jabgrall/Angel_Night-light/CAO/FreeCAD/Capot Batterie.FCStd

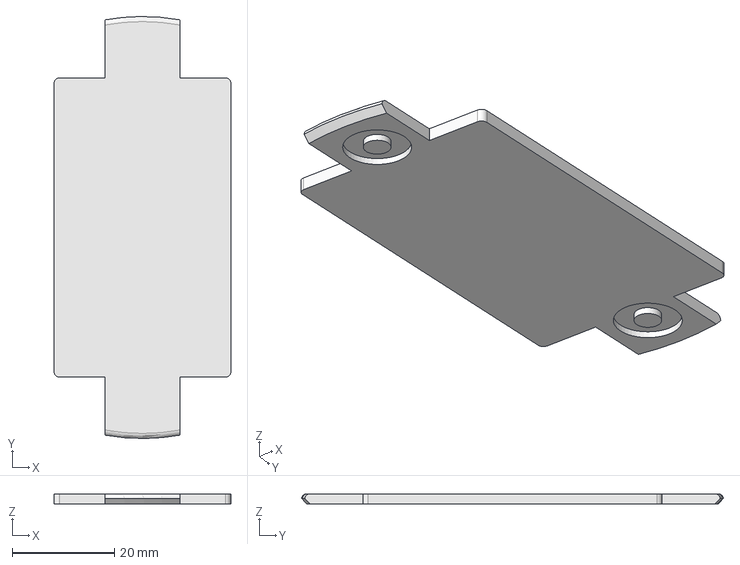
[picture p1: CAD file, 2022-08-26]
CAO/FreeCAD/Capot Batterie.FCStd
34.6 x 82.7 x 2.00 mm
