jabgrall/Angel_Night-light/CAO/FreeCAD/STL/V2_ElecTop-Fusion.stl

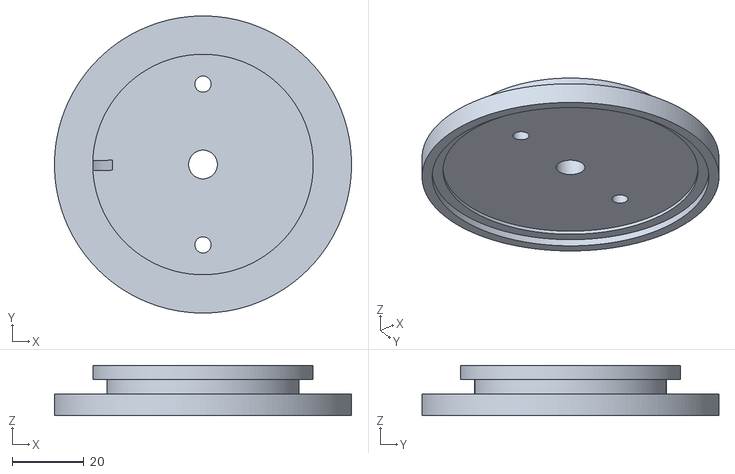
[picture p2: CAD file, 2022-08-25]
CAO/FreeCAD/STL/V2_ElecTop-Fusion.stl
82.7 x 82.6 x 14.0
