jabgrall/Angel_Night-light/CAO/FreeCAD/V2a_ElecBottom.FCStd

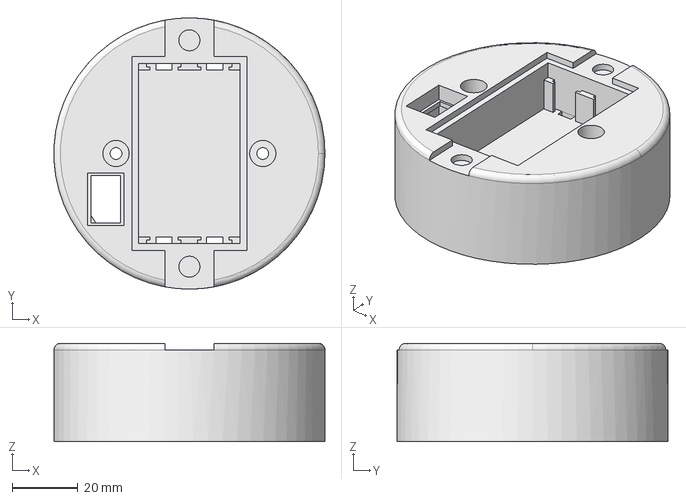
[picture p3: CAD file, 2022-08-25]
CAO/FreeCAD/V2a_ElecBottom.FCStd
82.6 x 82.7 x 30.0 mm
