jabgrall/Angel_Night-light/CAO/FreeCAD/Boitier Elec.FCStd

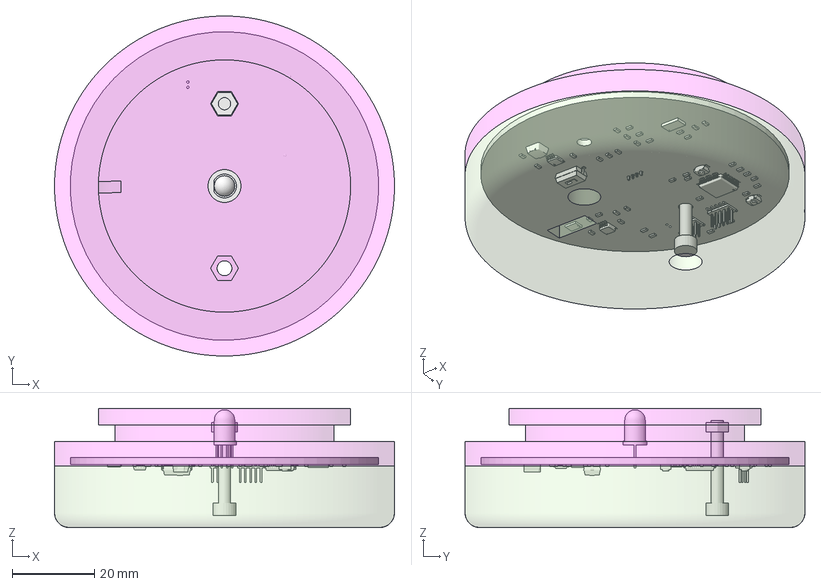
[picture p4: CAD file, 2022-03-18]
CAO/FreeCAD/Boitier Elec.FCStd
82.7 x 82.6 x 29.0 mm
PCB
Vis CHC M3x20
Ecrou M3
Ange-ElecTop
Ange-ElecBottom
