jabgrall/Angel_Night-light/CAO/FreeCAD/Ange_base.FCStd

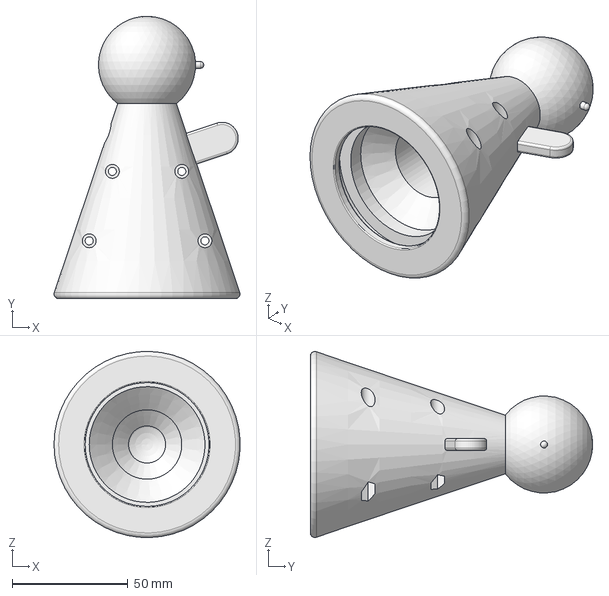
[picture p5: CAD file, 2022-03-18]
CAO/FreeCAD/Ange_base.FCStd
80.4 x 122.0 x 80.4 mm
