jabgrall/Angel_Night-light/CAO/FreeCAD/STL/PCB.stl

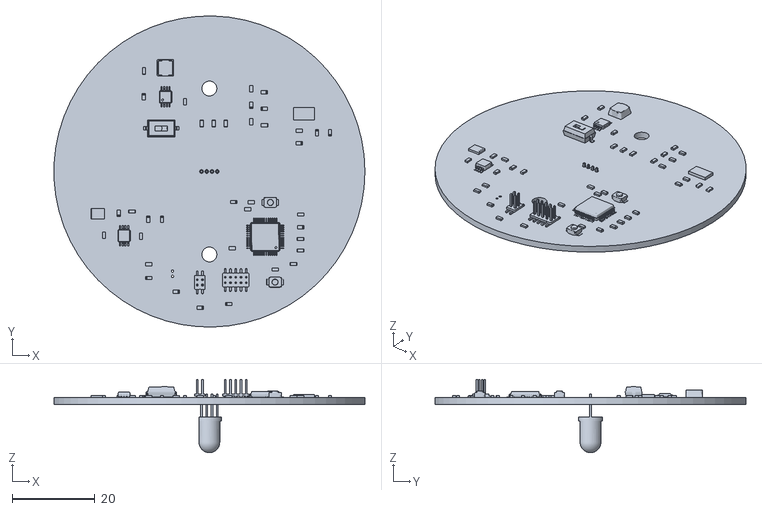
[picture p6: CAD file, 2021-09-29]
CAO/FreeCAD/STL/PCB.stl
75.0 x 75.0 x 17.7
