jabgrall/Angel_Night-light/CAO/FreeCAD/Ange_droite.FCStd

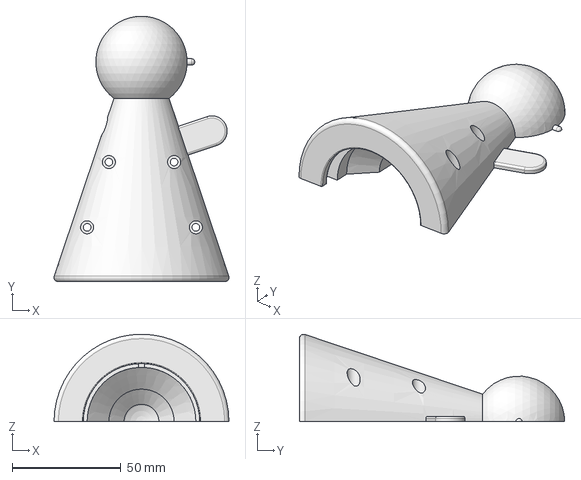
[picture p7: CAD file, 2021-09-29]
CAO/FreeCAD/Ange_droite.FCStd
80.4 x 122.0 x 40.2 mm
