jabgrall/Angel_Night-light/CAO/FreeCAD/Ange_aile.FCStd

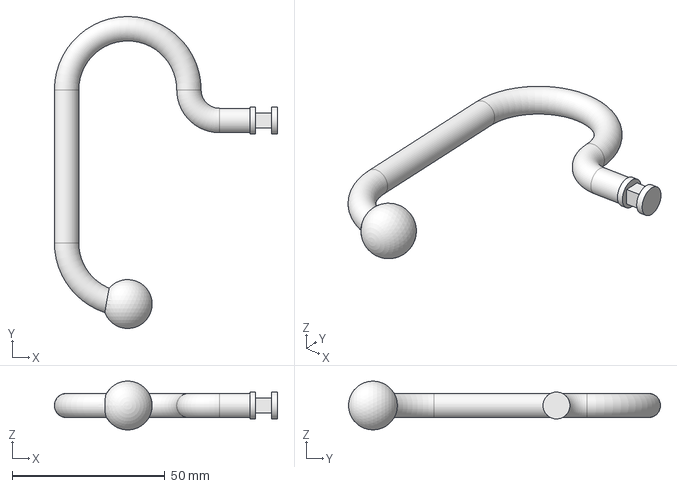
[picture p8: CAD file, 2021-09-29]
CAO/FreeCAD/Ange_aile.FCStd
73.0 x 102.0 x 15.9 mm
