jabgrall/Angel_Night-light/CAO/FreeCAD/Vis CHC M3x20.FCStd

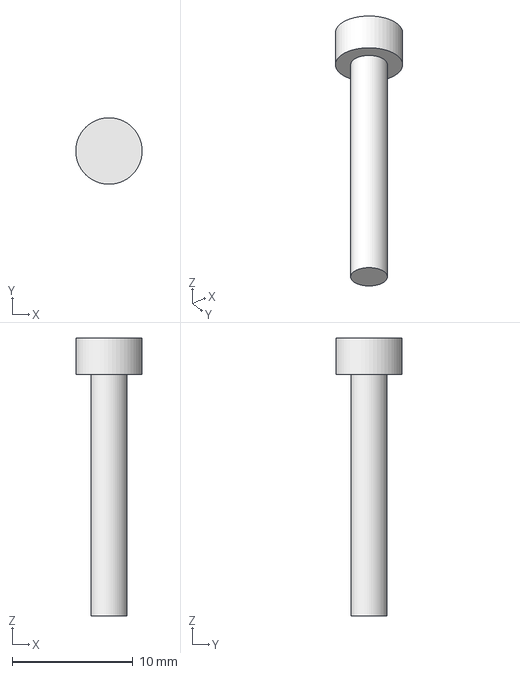
[picture p9: CAD file, 2021-09-29]
CAO/FreeCAD/Vis CHC M3x20.FCStd
5.49 x 5.50 x 23.0 mm
