jabgrall/Angel_Night-light/CAO/FreeCAD/Ecrou M3.FCStd

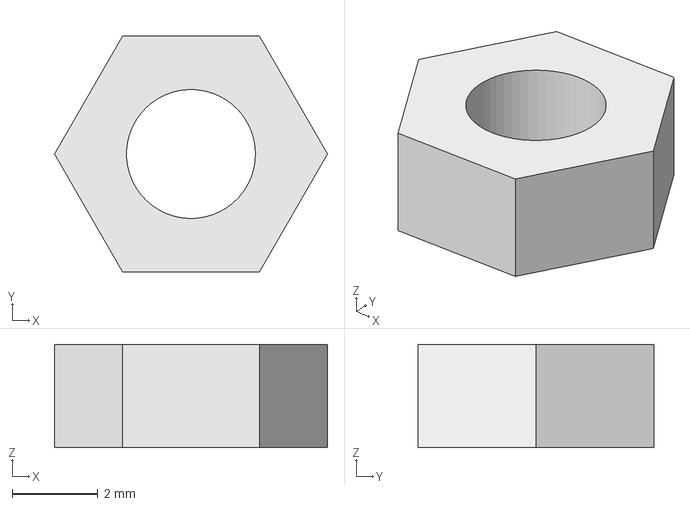
[picture p10: CAD file, 2021-09-29]
CAO/FreeCAD/Ecrou M3.FCStd
6.35 x 5.50 x 2.40 mm
