jabgrall/Angel_Night-light/CAO/FreeCAD/Ange_gauche.FCStd

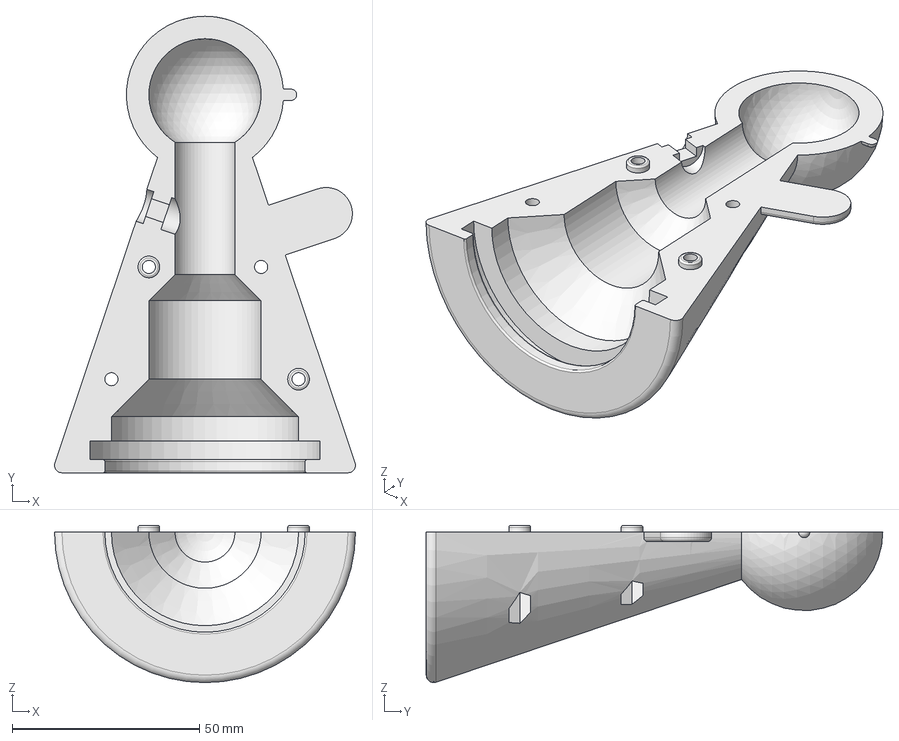
[picture p11: CAD file, 2021-09-29]
CAO/FreeCAD/Ange_gauche.FCStd
80.4 x 122.0 x 42.0 mm
