jabgrall/Angel_Night-light/(list of files, cad)

Other CAD files:
CAO/FreeCAD/STL/Capot Batterie-BodyPocket.stl
CAO/FreeCAD/STL/V2a_ElecBottom-BodyFillet.stl
CAO/FreeCAD/V2_ElecTop.FCStd
CAO/FreeCAD/STL/V2a_ElecTop-Fusion.stl
CAO/FreeCAD/STL/Ange_aile.stl
CAO/FreeCAD/STL/Ange_droite.stl
CAO/FreeCAD/STL/Ange_gauche.stl
CAO/FreeCAD/STL/Ecrou M3.stl
CAO/FreeCAD/STL/Vis CHC M3x20.stl
