jabgrall/Angel_Night-light/PCB/PCB-Ange.pdf

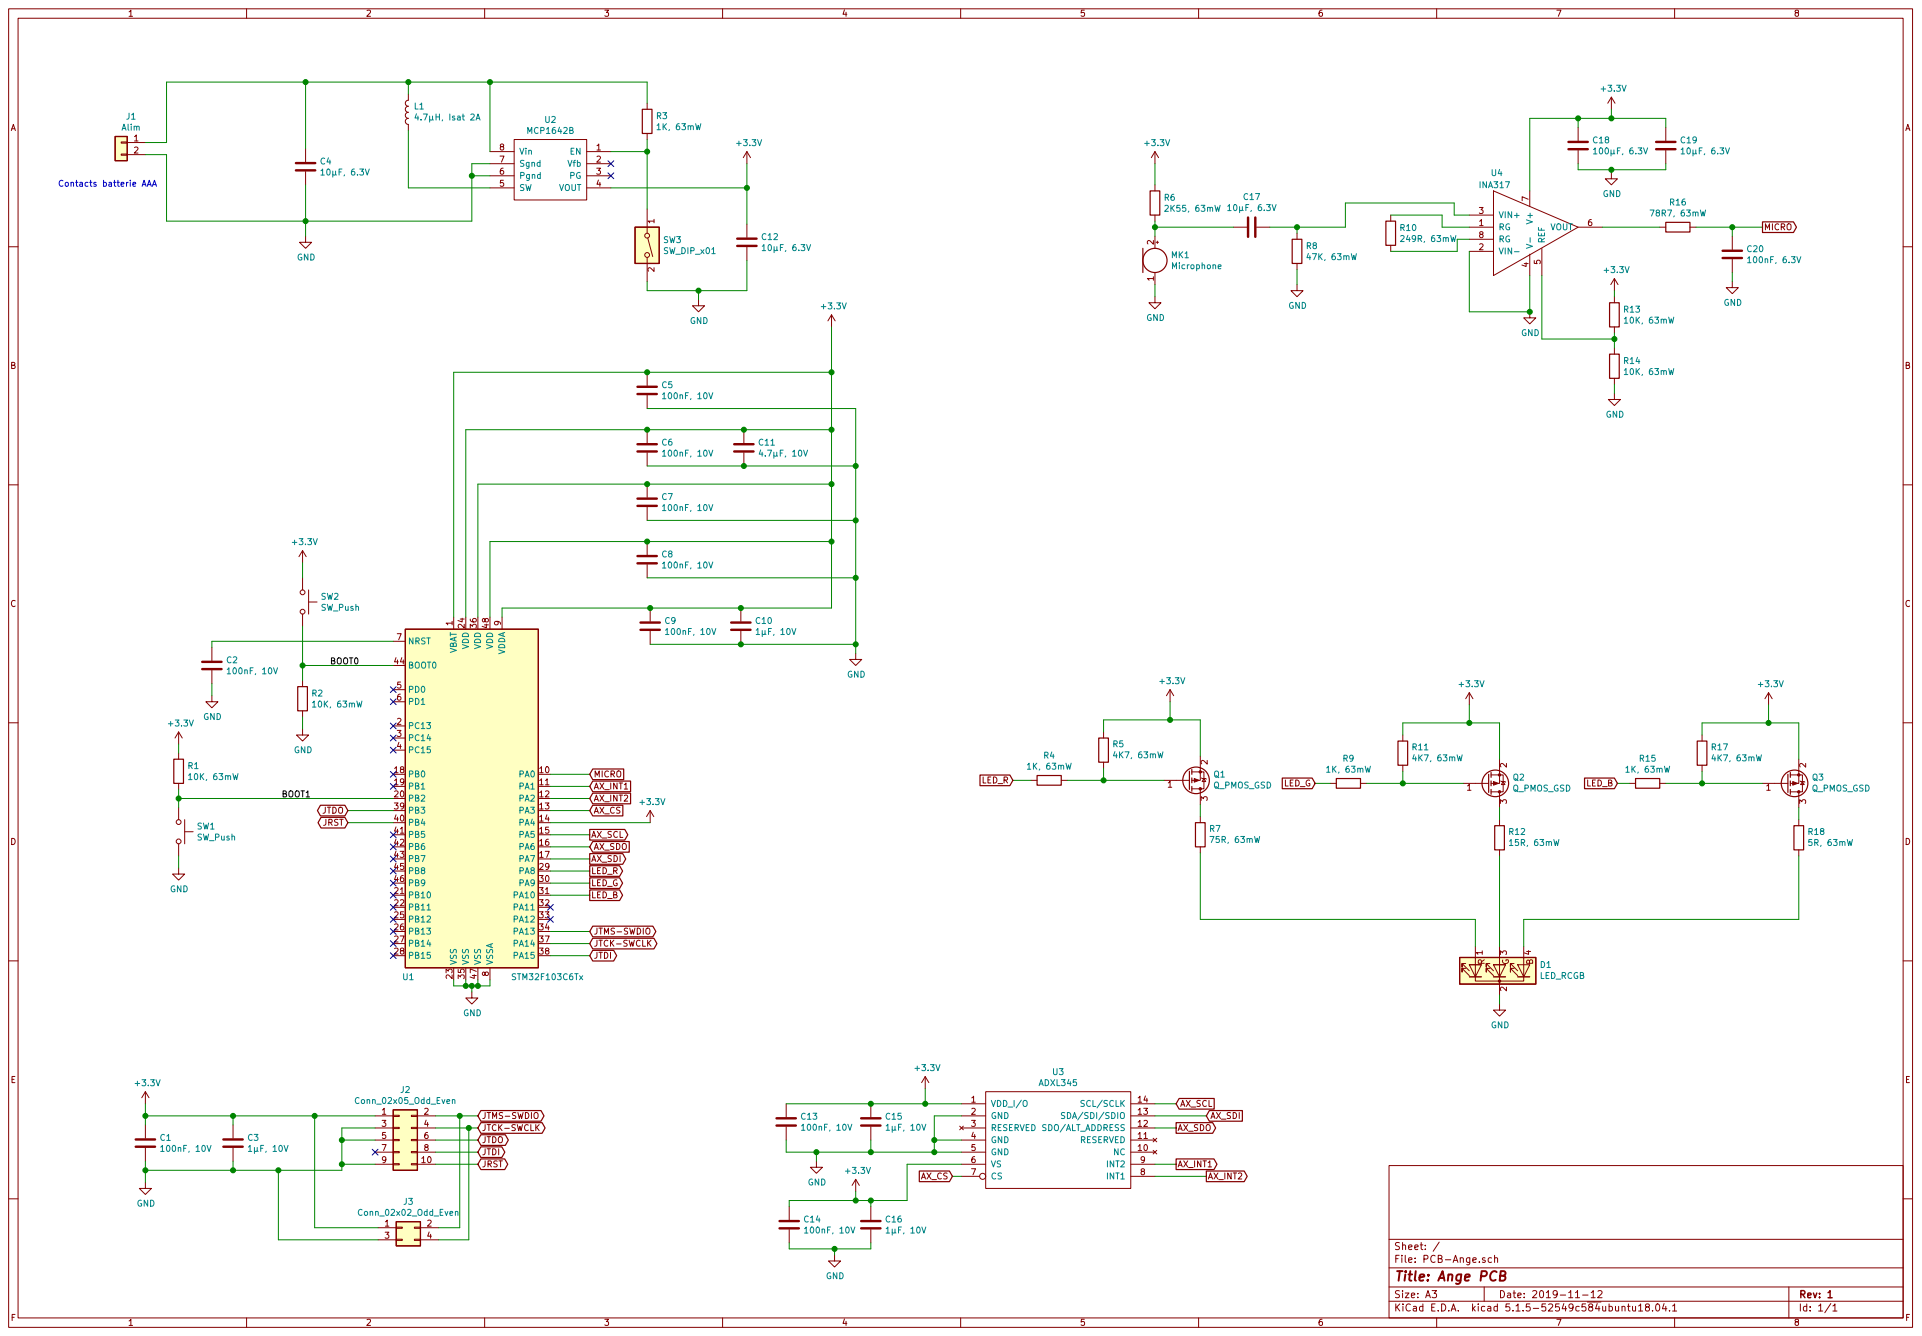
[picture p12: page 1]

1 2 MK1 Microphone RG 1 VIN- 2 VIN+ 3 V- 4 REF

1 VDD 24 VDD 36 VDD 48 VDDA

9 VSS 23 VSS 35 VSS 47 VSSA

7 9 | 8

File: PCB-Ange.sch Sheet: /
Id: 1/1 Title: Ange PCB
