jabgrall/Angel_Night-light/PCB/PCB-Ange.kicad_pcb

## KiCad design PCB/PCB-Ange.kicad_pcb (2022-08-25)

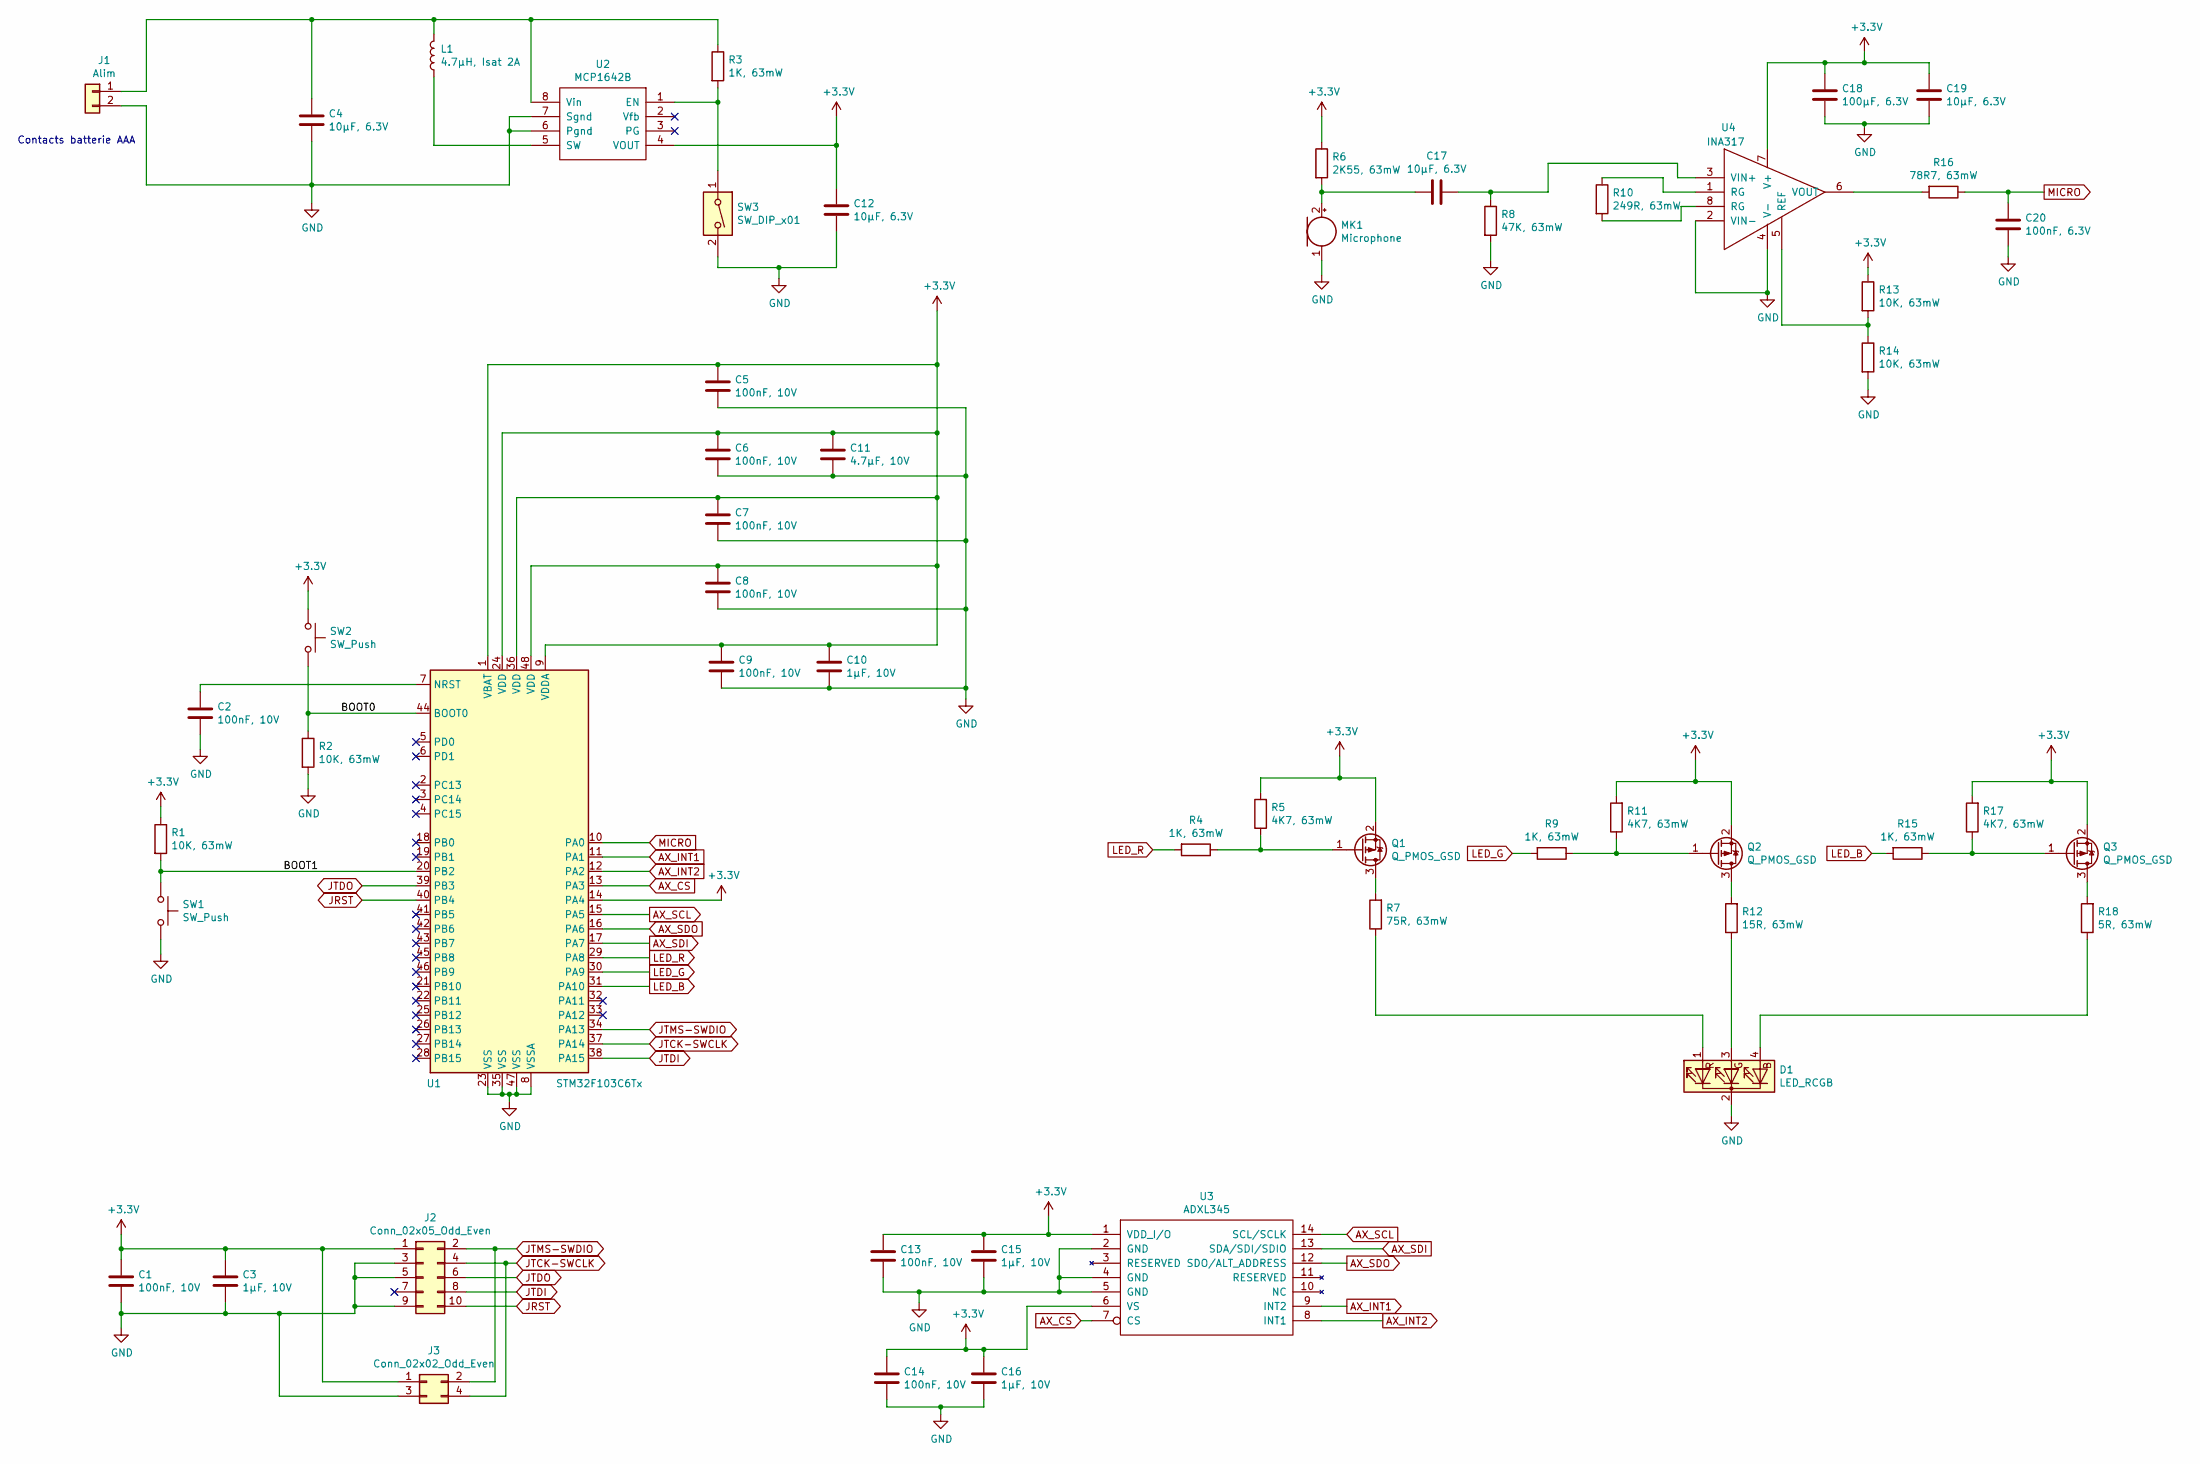
[picture p13: schematic PCB-Ange.sch, Ange PCB]

Parts:
C1, C2, C5, C6, C7, C8, C9, C13, C14: 100nF, 10V; R_0603_1608Metric_Pad1.05x0.95mm_HandSolder
C3, C10, C15, C16: 1µF, 10V; R_0603_1608Metric_Pad1.05x0.95mm_HandSolder
C4, C12, C17, C19: 10µF, 6.3V; R_0603_1608Metric_Pad1.05x0.95mm_HandSolder
C11: 4.7µF, 10V; R_0603_1608Metric_Pad1.05x0.95mm_HandSolder
C18: 100µF, 6.3V; R_1210_3225Metric_Pad1.42x2.65mm_HandSolder
C20: 100nF, 6.3V; R_0603_1608Metric_Pad1.05x0.95mm_HandSolder
D1: LED_RCGB; LED_D5.0mm-4_RGB
J1: Alim; Keystone_SMD_5230_AAA
J2: Conn_02x05_Odd_Even; PinHeader_2x05_P1.27mm_Vertical_SMD
J3: Conn_02x02_Odd_Even; PinHeader_2x02_P1.27mm_Vertical_SMD
L1: 4.7µH, Isat 2A; L_Bourns-SRN4018
MK1: Microphone; micro_4mm
Q1, Q2, Q3: Q_PMOS_GSD; SOT-723
R1, R2, R13, R14: 10K, 63mW; R_0603_1608Metric_Pad1.05x0.95mm_HandSolder
R3, R4, R9, R15: 1K, 63mW; R_0603_1608Metric_Pad1.05x0.95mm_HandSolder
R5, R11, R17: 4K7, 63mW; R_0603_1608Metric_Pad1.05x0.95mm_HandSolder
R6: 2K55, 63mW; R_0603_1608Metric_Pad1.05x0.95mm_HandSolder
R7: 75R, 63mW; R_0603_1608Metric_Pad1.05x0.95mm_HandSolder
R8: 47K, 63mW; R_0603_1608Metric_Pad1.05x0.95mm_HandSolder
R10: 249R, 63mW; R_0603_1608Metric_Pad1.05x0.95mm_HandSolder
R12: 15R, 63mW; R_0603_1608Metric_Pad1.05x0.95mm_HandSolder
R16: 78R7, 63mW; R_0603_1608Metric_Pad1.05x0.95mm_HandSolder
R18: 5R, 63mW; R_0603_1608Metric_Pad1.05x0.95mm_HandSolder
SW1, SW2: SW_Push; SW_SPST_B3U-1000P-B
SW3: SW_DIP_x01; SW_DIP_SPSTx01_Slide_6.7x4.1mm_W8.61mm_P2.54mm_LowProfile
U1: STM32F103C6Tx; LQFP-48_7x7mm_P0.5mm
U2: MCP1642B; MSOP-8_3x3mm_P0.65mm
U3: ADXL345; LGA-14_3x5mm_P0.8mm_LayoutBorder1x6y
U4: INA317; VSSOP-8_3.0x3.0mm_P0.65mm

Connections:
+3V3: C1.1, C3.1, C5.1, C6.1, C7.1, C8.1, C9.1, C10.1, C11.1, C12.1, C13.1, C14.1, C15.1, C16.1, C18.1, C19.1, J2.1, J3.1, Q1.2 (S), Q2.2 (S), Q3.2 (S), R1.1, R5.2, R6.1, R11.2, R13.1, R17.2, SW2.1, U1.1 (VBAT), U1.9 (VDDA), U1.14 (PA4), U1.24 (VDD), U1.36 (VDD), U1.48 (VDD), U2.4 (VOUT), U3.1 (VDD_I/O), U3.6 (VS), U4.7 (V+)
/BOOT0: R2.1, SW2.2, U1.44 (BOOT0)
/BOOT1: R1.2, SW1.1, U1.20 (PB2)
AX_CS: U1.13 (PA3), U3.7 (CS)
AX_INT1: U1.11 (PA1), U3.9 (INT2)
AX_INT2: U1.12 (PA2), U3.8 (INT1)
AX_SCL: U1.15 (PA5), U3.14 (SCL/SCLK)
AX_SDI: U1.17 (PA7), U3.13 (SDA/SDI/SDIO)
AX_SDO: U1.16 (PA6), U3.12 (SDO/ALT_ADDRESS)
GND: C1.2, C2.2, C3.2, C4.2, C5.2, C6.2, C7.2, C8.2, C9.2, C10.2, C11.2, C12.2, C13.2, C14.2, C15.2, C16.2, C18.2, C19.2, C20.2, D1.2 (K), J1.2, J2.3, J2.5, J2.9, J3.3, MK1.1 (-), R2.2, R8.2, R14.2, SW1.2, SW3.2, U1.8 (VSSA), U1.23 (VSS), U1.35 (VSS), U1.47 (VSS), U2.6 (Pgnd), U2.7 (Sgnd), U3.2 (GND), U3.4 (GND), U3.5 (GND), U4.2 (VIN-), U4.4 (V-)
JRST: J2.10, U1.40 (PB4)
JTCK-SWCLK: J2.4, J3.4, U1.37 (PA14)
JTDI: J2.8, U1.38 (PA15)
JTDO: J2.6, U1.39 (PB3)
JTMS-SWDIO: J2.2, J3.2, U1.34 (PA13)
LED_B: R15.2, U1.31 (PA10)
LED_G: R9.2, U1.30 (PA9)
LED_R: R4.2, U1.29 (PA8)
MICRO: C20.1, R16.1, U1.10 (PA0)
unnamed: C2.1, U1.7 (NRST)
unnamed: C4.1, J1.1, L1.2, R3.1, U2.8 (Vin)
unnamed: C17.1, R8.1, U4.3 (VIN+)
unnamed: C17.2, MK1.2 (+), R6.2
unnamed: D1.1 (RA), R7.1
unnamed: D1.3 (GA), R12.1
unnamed: D1.4 (BA), R18.1
unnamed: L1.1, U2.5 (SW)
unnamed: Q1.1 (G), R4.1, R5.1
unnamed: Q1.3 (D), R7.2
unnamed: Q2.1 (G), R9.1, R11.1
unnamed: Q2.3 (D), R12.2
unnamed: Q3.1 (G), R15.1, R17.1
unnamed: Q3.3 (D), R18.2
unnamed: R3.2, SW3.1, U2.1 (EN)
unnamed: R10.1, U4.1 (RG)
unnamed: R10.2, U4.8 (RG)
unnamed: R13.2, R14.1, U4.5 (REF)
unnamed: R16.2, U4.6 (VOUT)

Notes on the sheet:
Contacts batterie AAA

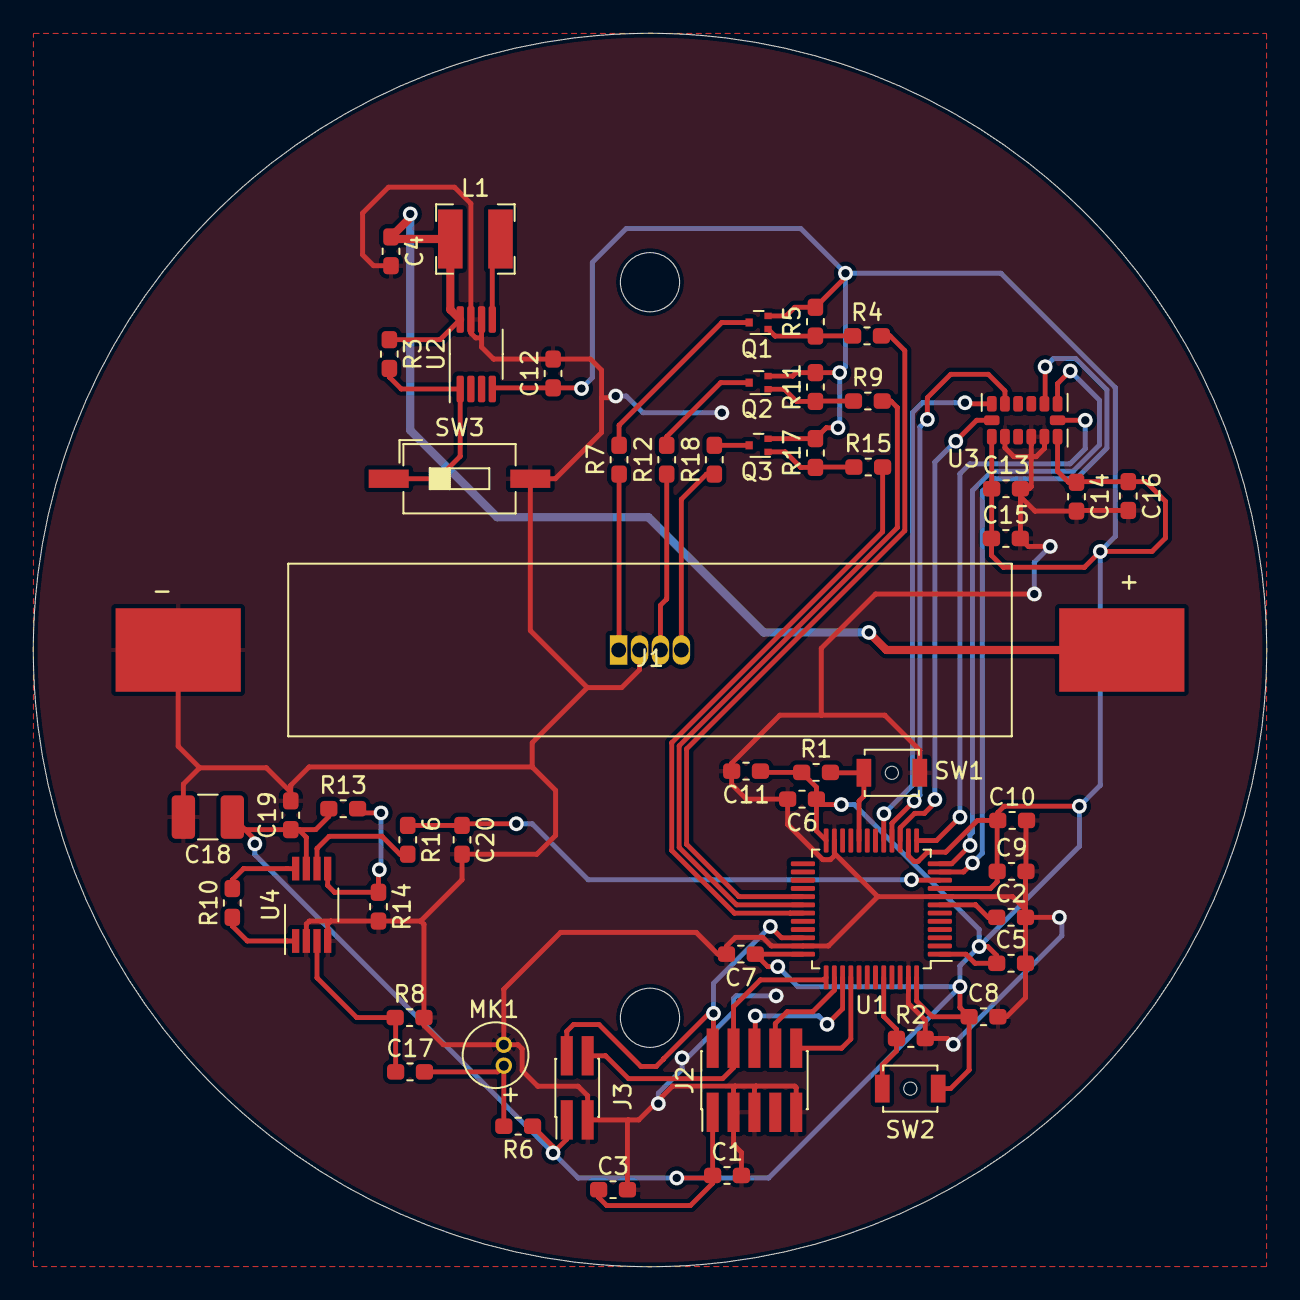
[picture p14: board PCB-Ange.kicad_pcb from above]

Board: 2 copper layers, 75.0 x 75.0 mm, 54 parts (1 on the bottom side), 38 nets.
