jabgrall/Angel_Night-light/(commit log)

2022-03-18 Update du 18 mars à 17:33
    [Ange_base.FCStd, Boitier Elec.FCStd, V2_ElecTop.FCStd]
2022-06-29 update du 29/06/22 à 21:17
    [Capot Batterie-BodyPocket.stl, Capot Batterie.FCStd, V2_ElecTop-Fusion.stl, V2_ElecTop.FCStd, V2a_ElecBottom-BodyFillet.stl, V2a_ElecBottom.FCStd]
2022-08-24 Update du 24/08/22 à 21:34
    [V2a_ElecBottom-BodyFillet.stl, V2a_ElecBottom.FCStd, V2a_ElecTop-Fusion.stl]
2022-08-24 Update du 24/08/22 à 22:17
    [Ange-Aile.stl, Ange-ElecBottom.stl, Ange-ElecTop.stl, Ange-MouleIntD.stl, Ange-MouleIntG.stl, Ange-new.stl, Ange-test.stl]
2022-08-25 Update du 25/08/22 à 07:56
    [PCB-Ange-B_Cu.gbr, PCB-Ange-B_Mask.gbr, PCB-Ange-B_Paste.gbr, PCB-Ange-B_Silkscreen.gbr, PCB-Ange-Edge_Cuts.gbr, PCB-Ange-F_Cu.gbr, PCB-Ange-F_Mask.gbr, PCB-Ange-F_Paste.gbr]
2022-08-26 Update du 26/08/22 à 7:53
    [Capot Batterie-BodyPocket.stl, Capot Batterie.FCStd]
2022-09-20 Update du 20/09/2022 à 7h47
    [Essais calcul d'angle.ods]
2022-10-18 Update du 18/10/2022 à 07:31.
    [Essais calcul d'angle.ods]
